AdrieHuesman/Arduino-Nano-based-robot/IMG_20230617_173425.jpg

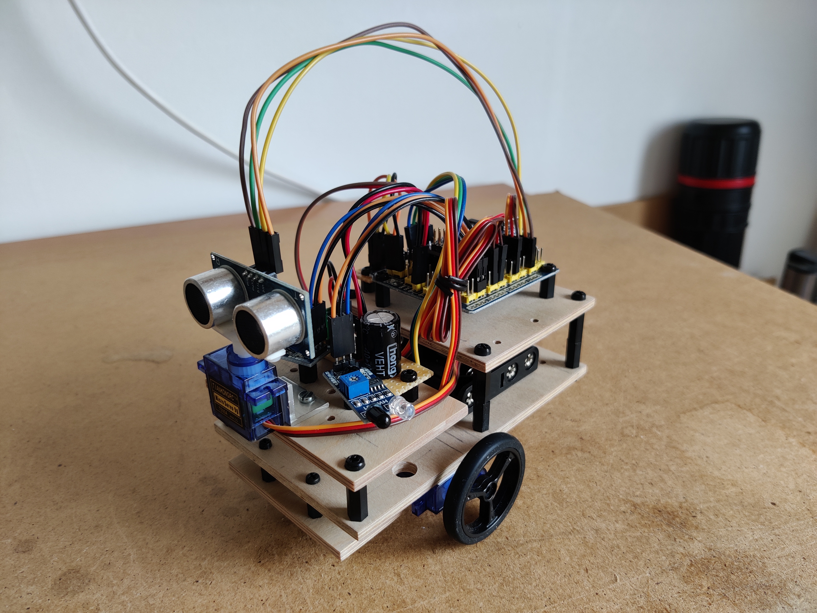
IMG_20230617_173425.jpg
