AdrieHuesman/Arduino-Nano-based-robot/README.md

# To see the robot in action: https://www.youtube.com/watch?v=1tpgiUhWIU4
# To see more action: https://www.youtube.com/watch?v=7YnH9MPE9Z4
